Fredrik1ST/TTK4155-ping-pong-machine/Node1/def.h

/**
 * @file def.h
 * @brief System-specific definitions, e.g. CPU clock frequency
 */

#ifndef DEF_H
#define DEF_H

#include <inttypes.h>

// Global game variables
uint8_t gScore;
uint8_t gHighScores[2];
uint8_t gMem;
#define DEF_START_GAME gMem |= (1 << 0)
#define DEF_STOP_GAME gMem &= ~(1 << 0)
#define DEF_GAME_ACTIVE ((gMem & (1 << 0)) != 0)

// Times
#define F_CPU 4915200								// Set clock frequency to 4,9MHz
#define DEF_BAUD 9600
#define DEF_UBBR F_CPU/16/DEF_BAUD - 1				// UART baud rate from datasheet
#define DEF_ADC_CONV_TIME 1000000*9*4*2/F_CPU + 10	// ADC Conversion time [microseconds] with 10us leeway

// Macros for chip select on CAN controller
#define DEF_CAN_CS_ENABLE DDRB |= (1<<PB4)	// Enable pin as output
#define DEF_CAN_CS_ON PORTB &= ~(1<<PB4)	// Chip select activate (pin low)
#define DEF_CAN_CS_OFF PORTB |= (1<<PB4)	// Chip select deactivate (pin high)

// External RAM addresses
#define DEF_ADR_SRAM 0x1800			// Start address for the SRAM
#define DEF_ADR_ADC 0x1400			// Start address for the ADC
#define DEF_ADR_OLED_DATA 0x1200	// Start address for the OLED Data
#define DEF_ADR_OLED_CMD 0x1000		// Start address for the OLED Commands

#define DEF_ADC_CHANNELS 4			// Number of ADC channels

#endif // DEF_H
