Fredrik1ST/TTK4155-ping-pong-machine/Node1/main.c

// Warning: Compiler optimization in Microchip Studio may cause wacky behavior
// Go to Project > Properties > Toolchain > Optimization if having trouble with output or timing on address pins

#include <util/delay.h>
#include <inttypes.h> // Needed for uint8_t, uint16_t, etc.
#include <avr/io.h>

#include "def.h" // System-specific definitions (e.g. CPU clock frequency, SRAM addresses)
#include "uart.h"
#include "sram.h"
#include "adc.h"
#include "gamepad.h"
#include "oled.h"
#include "menu.h"
#include "spi.h"
#include "mcp2515.h"
#include "can.h"
#include "game.h"

int main(void) {
	UART_init(DEF_UBBR);
	SRAM_init();
	adc_init();
	gamepad_init();
	oled_init();
	oled_reset();
	menu_init();
	can_init();
	
	Gamepad gp;
	Dir new_gp_dir;
	Dir prev_gp_dir;
	gp = read_gamepad(gp);
	gp = calibrate_gamepad(gp);
	
	uint32_t clk = 0;
	uint32_t prevClk = 0;
	uint8_t ballDetected = 0;
	
	printf("Init OK");
	
	while(1){
		// =================================================
		// Read gamepad inputs
		
		gp = read_gamepad(gp);
		gp = calibrate_gamepad(gp);
		new_gp_dir = getJoystickDir(gp);
		uint8_t prev_gp_btn;
		
		
		// =================================================
		// Display menu on OLED
		
		oled_reset();
		if (new_gp_dir == UP && prev_gp_dir != UP ){
			menu_moveCursor(-1);
		}
		else if (new_gp_dir == DOWN && prev_gp_dir != DOWN ){
			menu_moveCursor(1);
		}
		if(gp.btn & !prev_gp_btn){
			
			// Leave Highscore
			if (menu_is_highscore()){
				menu_move_back();
			}else{
				menu_selectPage();
			}
		}else{
			menu_run();
		}
		//menu_print();
		prev_gp_dir = new_gp_dir;
		prev_gp_btn = gp.btn;

		
		// =================================================
		// CAN Communications
		
		CanMsg msgOut;
		msgOut.id = 0x42; // Not used for anything, since there's only one message type
		msgOut.len = 4;
		msgOut.data[0] = gp.pos_x;
		msgOut.data[1] = gp.pos_y;
		msgOut.data[2] = gp.btn;
		msgOut.data[3] = DEF_GAME_ACTIVE;
		can_send(&msgOut);
		printf("Sent: ID: %02X    -    Len: %02X    -    Dat: %02X %02X %01X %01X \r\n\r\n", msgOut.id, msgOut.len, msgOut.data[0], msgOut.data[1], msgOut.data[2], msgOut.data[3]);

		// Read incoming CAN message when interrupt flag is set
		if (mcp2515_read(MCP_CANINTF)&(0x01)){
			CanMsg msgIn;
			can_recv(&msgIn);
			ballDetected = msgIn.data[0] & (1 << 0);
			//printf("Recv: ID: %02X    -    Len: %02X    -    Dat: %02X %02X \r\n\r\n", msgIn.id, msgIn.len, msgIn.data[0], msgIn.data[1]);
		}
		
	
		// =================================================
		// Game logic - Increment score until ball is detected by IR (NB! Game is started by menu function)
		if (DEF_GAME_ACTIVE){
			// Score
			clk++;
			if ((clk > prevClk + 10)|(clk < prevClk)){
				gScore++;
				prevClk = clk;
			}
			// Game over
			if (ballDetected != 0) {
				update_highscore();
				gScore = 0;
				menu_move_back();
				DEF_STOP_GAME;
			}
		}
	
	}
	return 0;
}
