Fredrik1ST/TTK4155-ping-pong-machine/Node2/can.h

/**
 * @file can.h
 * 
 * @brief CAN Bus functionality for ATSAM3X8E
 * 
 * Code provided by course staff for TTK4155
 */ 
#pragma once

#include <stdint.h>
#include "can.h"

uint32_t canRxDword[2];
uint8_t canRxByte[8];

/**
 * @struct Initialization parameters for CAN
 * See `can_init` for usage example
 */ 
typedef struct CanInit CanInit;
__attribute__((packed)) struct CanInit {
    union {
        struct {
            uint32_t phase2:4;  // Phase 2 segment
            uint32_t propag:4;  // Propagation time segment
            uint32_t phase1:4;  // Phase 1 segment
            uint32_t sjw:4;     // Synchronization jump width
            uint32_t brp:8;     // Baud rate prescaler
            uint32_t smp:8;     // Sampling mode
        };
        uint32_t reg;
    };
};


/**
* @brief Initialize CAN bus, with bit timings and optional interrupt

* If `rxInterrupt` is not 0, an interrupt will be triggered when a message is received.
* (See can.c for an example interrupt handler)
* Example:
*    can_init((CanInit){.brp = F_CPU/2000000-1, .phase1 = 5, .phase2 = 1, .propag = 6}, 0);
*/
void can_init(CanInit init, uint8_t rxInterrupt);


/**
 * @brief Strict-aliasing-safe reinterpret-cast
*/
#define union_cast(type, x) \
    (((union { \
        typeof(x) a; \
        type b; \
    })x).b)


/**
* @brief CAN message data type
* Data fields have 3 access methods (via union):
*  8 bytes
*  2 double words (32-bit ints)
*  1 Byte8 dummy struct
* The dummy struct allows for convenient construction of a CAN message from another type
*
* Example:
*    typedef struct {
*        uint16_t  a;
*        uint8_t   b;
*        float     c;
*    } __attribute__((packed)) YourStruct ;
*    
*    CanMsg m = (CanMsg){
*        .id = 1,
*        .length = sizeof(YourStruct),
*        .byte8 = union_cast(Byte8, ((YourStruct){
*            .a = 10,
*            .b = 20,
*            .c = -30.0,
*        })),
*    };
*    can_printmsg(m);
*    Should print: CanMsg(id:1, length:7, data:{10, 0, 20, 0, 0, 240, 193})
*/
typedef struct {
    uint8_t id;
    uint8_t length;
	uint8_t byte[8];
	uint32_t dword[2];
} CanMsg;


/**
* @brief Send a CAN message on the bus.
* Blocks if the bus does not receive the message (typically because one of the 
* receiving nodes has not cleared a buffer)
*/
void can_tx(CanMsg m);

/**
* @brief Receive a CAN message.
* Does not block. Returns 0 if there is no message, 1 otherwise
*/
uint8_t can_rx(CanMsg* m);

/**
* @brief Print a CAN message (using `printf`)
*/
void can_printmsg(CanMsg* m);
