Fredrik1ST/TTK4155-ping-pong-machine/Node2/ir.h

#ifndef IR_H
#define IR_H

#include <sam.h>

/**
 * @brief Initialize the IR pin
 */
void IR_init(void);

/**
 * @brief Reads the IR pin
 * 
 * @return int 
 */
uint8_t getIR(void);

#endif /* IR_H */
