Fredrik1ST/TTK4155-ping-pong-machine/Node1/spi.h

/**
 * @file spi.h
 * @brief Serial Peripheral Interface (SPI) for ATMega162
 */

#ifndef SPI_H
#define SPI_H

/**
* @brief Initialize the SPI interface as master. Uses PB4 as inverted chip select pin.
*/
void spi_init(void);


/**
* @brief Send 8 bits over SPI as master
* @param	cData	Byte to be transmitted
*/
void spi_send(char cData);

/**
* @brief Receive 8 bits over SPI as master
*/
uint8_t spi_recv(void);

#endif /* SPI_H */
