Fredrik1ST/TTK4155-ping-pong-machine/(commit log)

2024-09-12 Solved lab task 1 with printf
    [main.c, square_wave_test.c, uart.c, uart.h]
2024-09-19 Solved task 2 (SRAM Test with NAND address decoding)
    [main.c, sram.c, sram.h]
2024-09-25 Added code to test ADC
2024-09-26 Update README.md
    Added info about the USB multifunction board for task 3
2024-09-27 Refactoring. Updated init and functions for ADC.
2024-10-02 WIP Still testing ADC
2024-10-10 OLED Print tested and working
2024-10-17 Added Lab5 SPI & CAN functions
    Updated README.md
2024-10-24 WIP CAN between Node 1 & 2
    CAN messages from node 1 tested with oscilloscope. Format of received messages in node 2 still wrong.
    [can.c, can.h, def.h, main.c, mcp2515.c, uart.c, uart.h]
2024-10-30 Recalculated CAN Bit timing
    [CAN_Bit_Timing.ods]
2024-10-30 Added PWM functions for node 2
    [CAN_Bit_Timing.ods]
2024-10-31 Updated CAN
    [CAN_Bit_Timing.ods]
2024-11-05 Added basic IR driver and Game logic
2024-11-05 Added encoder code
2024-11-06 WIP Encoder
2024-11-07 Change did not work well - reverted
    [menu.c]
2024-11-07 Tested motor speed control
2024-11-08 Add comments to encoder.h
2024-11-08 Add motor controller
2024-11-08 Tested motor position PI controller
2024-11-11 WIP game - Moved to correct Node
    [game.c, menu.c]
2024-11-11 Alpha Supreme PID controller
    Good luck winning
2024-11-11 Merged new menu with PID
2024-11-15 Fix wrong comments for CAN Node 1
    [mcp2515.c]
2024-11-15 Fix CAN Bit timing spreadsheet
    [CAN_Bit_Timing.ods]
2024-11-21 Re-merge lost PID controller
